nariIng/memoire/Titrator/images/arduino_nano.webp

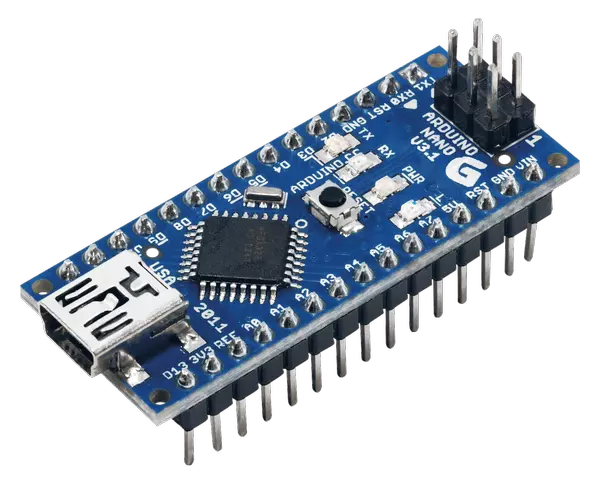
Titrator/images/arduino_nano.webp
