nariIng/memoire/Titrator/images/capteur_pH.jpg

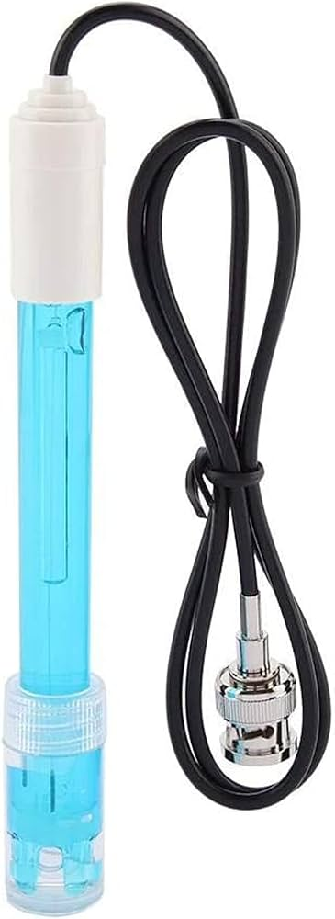
Titrator/images/capteur_pH.jpg
