nariIng/memoire/Titrator/images/charge.jpg

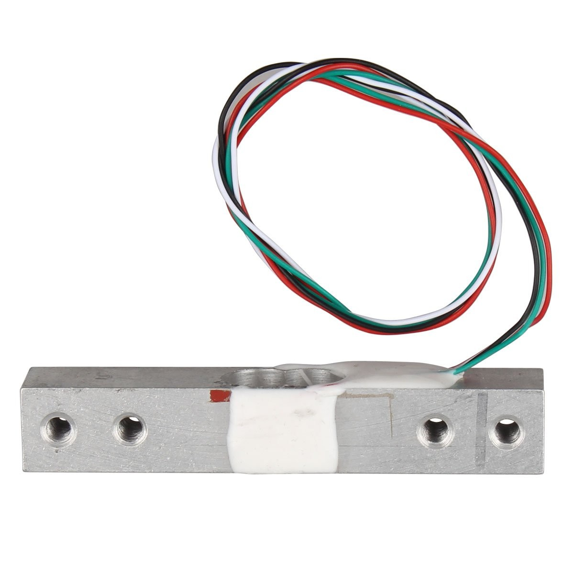
Titrator/images/charge.jpg
