nariIng/memoire/Titrator/images/esp32.jpg

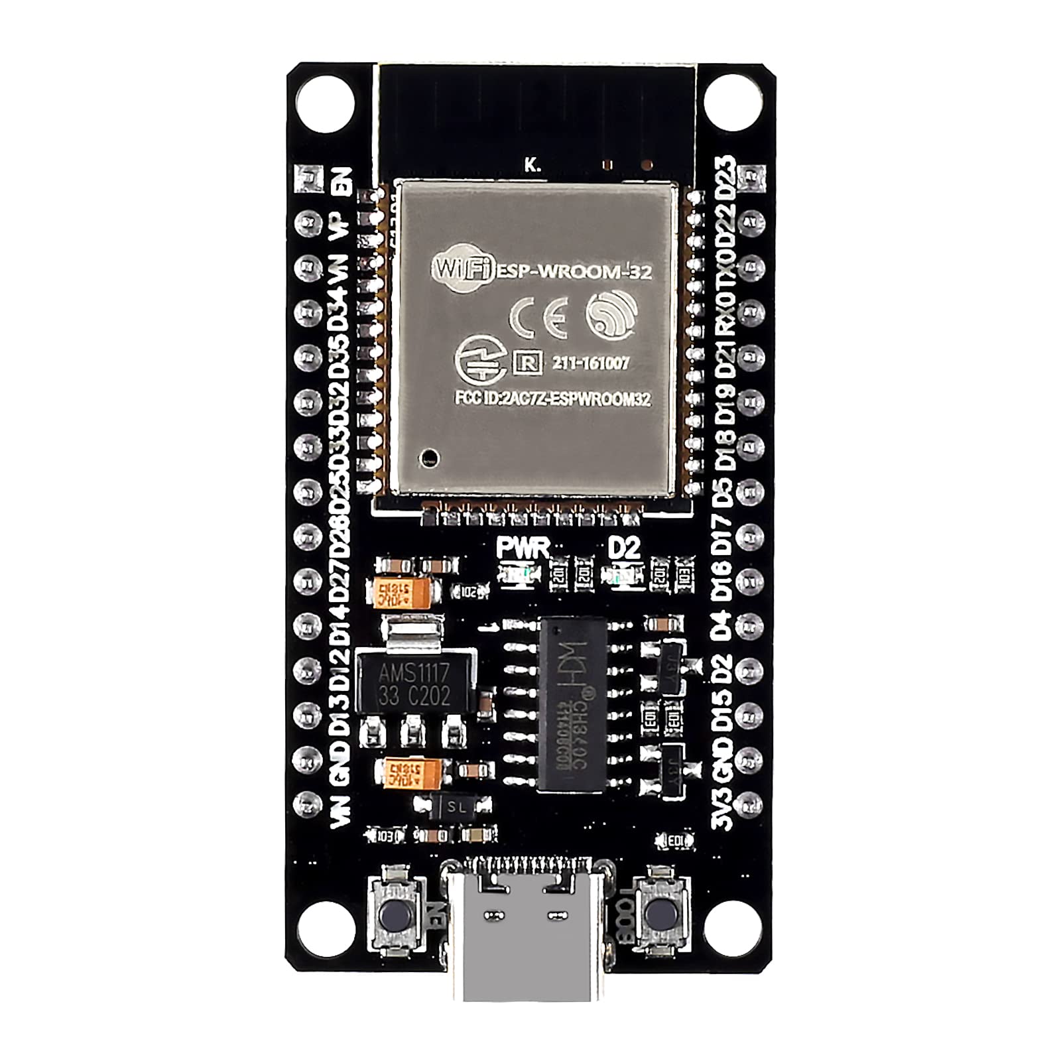
Titrator/images/esp32.jpg
