nariIng/memoire/Titrator/images/moteur.png

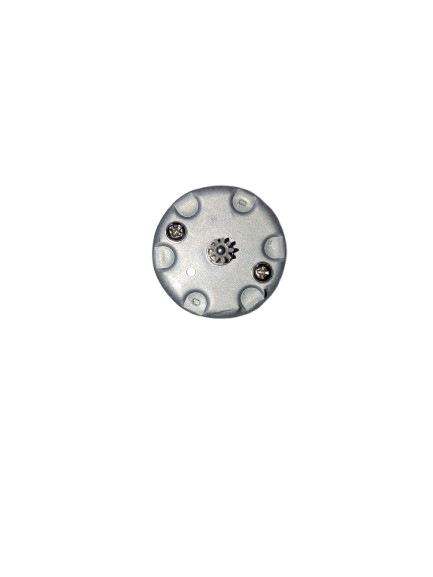
Titrator/images/moteur.png
