nariIng/memoire/Titrator/images/pompe.jpg

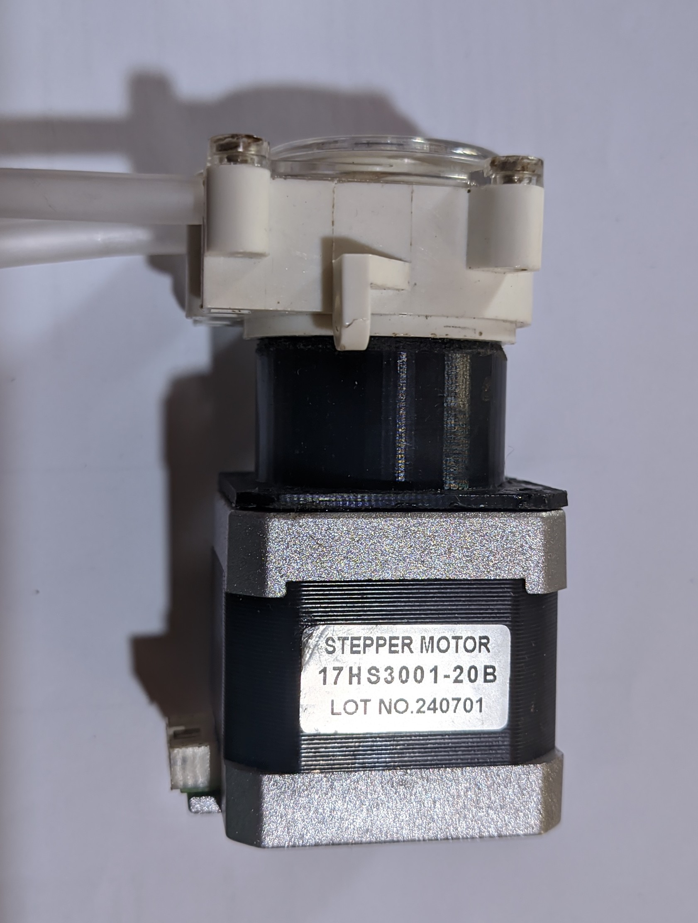
Titrator/images/pompe.jpg
